westlicht/kicad-libs/(commit log)

2017-09-06 added w_connector library and footprints
2017-09-06 added w_rotary_encoder library and footprints
2017-09-06 added switch library
2017-10-11 updated jack OSH footprints
2017-10-11 work on footprints
2017-10-12 fixed footprints
2017-10-24 fixed pads and silkscreen
2017-10-28 added via footprints
2017-10-28 added frontpanel footprints
2017-10-29 USB connector with slotted pads
2017-10-30 fixed pin mapping
2017-10-30 fixed silkscreen
2018-05-04 added LTL1BEKVJNN footprint
2018-05-10 added footprints
2018-05-13 updated usb frontpanel footprint
2018-10-06 replaced mounting holes to M2.5 pads
2018-11-19 enlarged frontpanel footprint for USB connector
2019-02-06 added thonkiconn connectors
2019-03-18 updated to kicad5
2019-03-18 updated setup script to kicad5
2019-04-08 added thonkiconn footprints and 3d models
2019-04-08 added kycon usb connector and 3d model
2019-08-28 added spdt subminiature toggle switch
2019-09-15 adjusted courtyard and mounting pads
2019-09-18 added mouse bite footprint
2019-09-19 updated mousebite footprints
2019-12-04 updated subminiature switches
2021-12-29 cleanup thonkiconn footprints
2023-11-18 update symbols to new kicad format
2023-11-18 update setup script for kicad7
2023-11-19 add RAXX45F footprints and 3d models
